gertminov/autoFilmScanner/resources/Scanwatcher.50.png

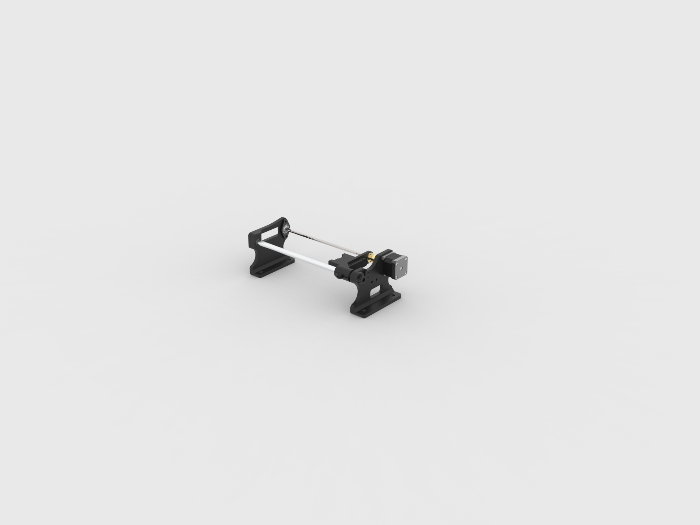
resources/Scanwatcher.50.png
