gertminov/autoFilmScanner/3dprint files/plustek_opticFilm_scanner v4.step

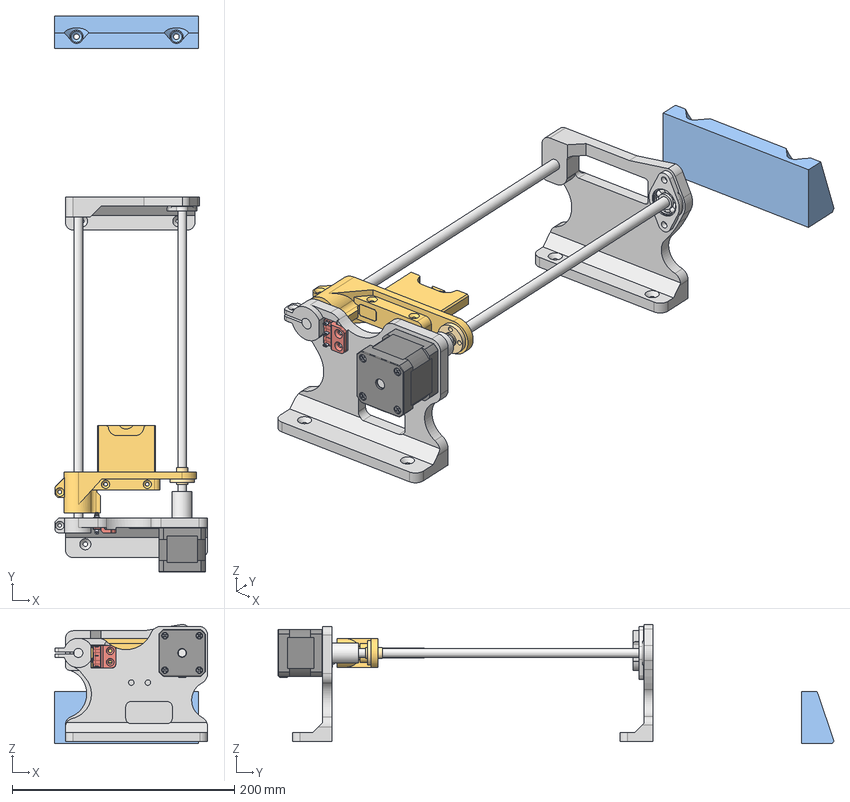
[picture p5: CAD file, 2022-12-11]
3dprint files/plustek_opticFilm_scanner v4.step
138.2 x 500.9 x 107.4 mm
Frontplate
Backplate
Connenctor
Housing
Bearing dummy
Bearing dummy 01
Core
M3x34-Screw
M3x34-Screw001
M3x34-Screw002
M3x34-Screw003
leadscrew_nut
sled
pusher
LM8UU_linear_bearing
plate_2
plate_1
endstop_switch
linear_rod
lead_screw
motor_coupling
Housing (1)
Bearing
block to hold scanner
