gertminov/autoFilmScanner/(list of files, cad)

Other CAD files:
3dprint files/plustek_opticFilm_scanner v4.f3d
3dprint files/plustek_opticFilm_scanner v4.iges
