gertminov/autoFilmScanner/schematic/schematic.pdf

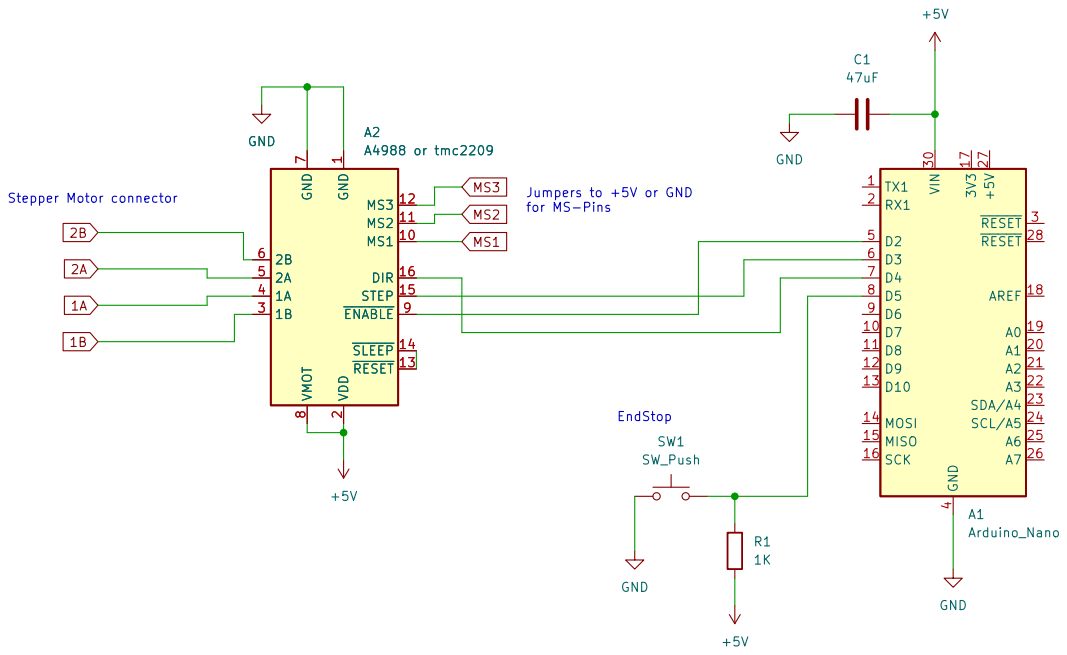
[picture p6: page 1]

1 MS1 10 MS2 11 MS3 12 ~{RESET}13 ~{SLEEP}14 STEP 15 DIR 16 VDD
File: opti_filmscanner.kicad_sch Sheet: / GND
