gertminov/autoFilmScanner/schematic/opti_filmscanner.kicad_sch

## KiCad design schematic/opti_filmscanner.kicad_sch (2022-12-10)

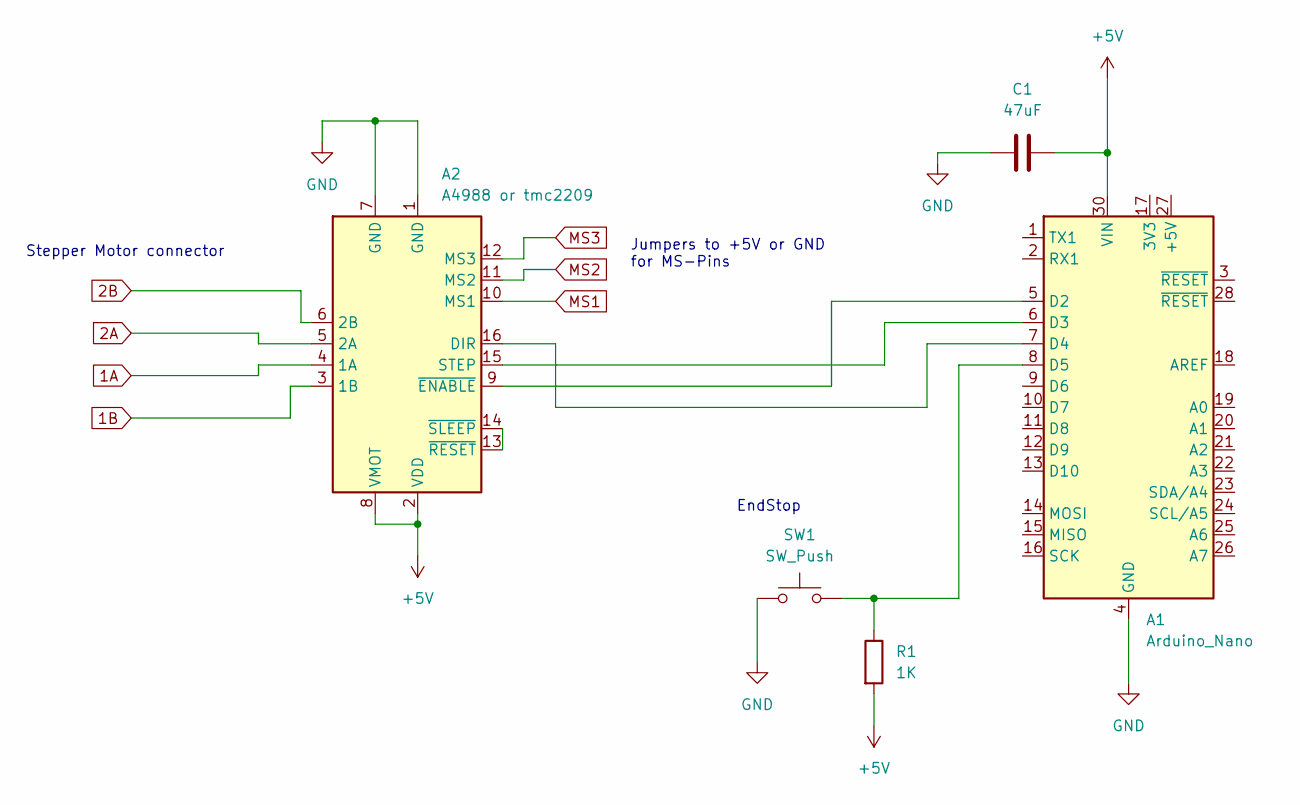
[picture p7: schematic opti_filmscanner.kicad_sch]

Parts:
A1: Arduino_Nano
A2: A4988 or tmc2209; Pololu_Breakout-16_15.2x20.3mm
C1: 47uF
R1: 1K
SW1: SW_Push

Connections:
1A: A2.4 (1A)
1B: A2.3 (1B)
2A: A2.5 (2A)
2B: A2.6 (2B)
MS1: A2.10 (MS1)
MS2: A2.11 (MS2)
MS3: A2.12 (MS3)
unnamed: A1.5 (D2), A2.9 (~ENABLE)
unnamed: A1.6 (D3), A2.15 (STEP)
unnamed: A1.7 (D4), A2.16 (DIR)
unnamed: A1.8 (D5), R1.1, SW1.2
unnamed: A1.4 (GND), A1.29 (GND)
unnamed: A1.30 (VIN), C1.2
unnamed: A2.1 (GND), A2.7 (GND)
unnamed: A2.2 (VDD), A2.8 (VMOT)
unnamed: A2.13 (~RESET), A2.14 (~SLEEP)

Notes on the sheet:
EndStop
Jumpers to +5V or GND for MS-Pins
Stepper Motor connector
