gertminov/autoFilmScanner/(commit log)

2022-09-21 added readme and arduino file
2022-12-10 Add files via upload
    rather inefficient CAD design but all I have for now, a redesign would be a good idea
    [plustek_opticFilm_scanner v19.f3d, plustek_opticFilm_scanner v19.iges, plustek_opticFilm_scanner v19.step]
2022-12-10 added schematics
    [opti_filmscanner.kicad_sch]
2022-12-10 expanded readme
    [opti_filmscanner.kicad_sch]
2022-12-11 updated 3d files
    [plustek_opticFilm_scanner v19.f3d, plustek_opticFilm_scanner v19.iges, plustek_opticFilm_scanner v19.step, plustek_opticFilm_scanner v4.f3d, plustek_opticFilm_scanner v4.iges, plustek_opticFilm_scanner v4.step]
